jamiebrind/esp32-roller-blind/THIRD_PARTY_NOTICES.md

# Third-party notices

Dependencies are not vendored as library source in this repository. Prebuilt firmware contains code from the installed toolchain and libraries:

- Arduino-ESP32 3.3.12: https://github.com/espressif/arduino-esp32 — LGPL-2.1; see its licence files and component notices.
- ESP-IDF and its components: https://github.com/espressif/esp-idf — Apache-2.0 for ESP-IDF, with additional component licences/notices.
- ArduinoJson 7.4.3: https://github.com/bblanchon/ArduinoJson — MIT.

The Creative Commons licence on this adaptation does not replace these dependency licences. Corresponding application source, build versions and build instructions are provided under firmware/ and docs/FIRMWARE.md. Retrieve dependency source and notices from the linked upstream releases when rebuilding or redistributing binaries.
