jamiebrind/esp32-roller-blind/cad/RollerBlind_V15.step

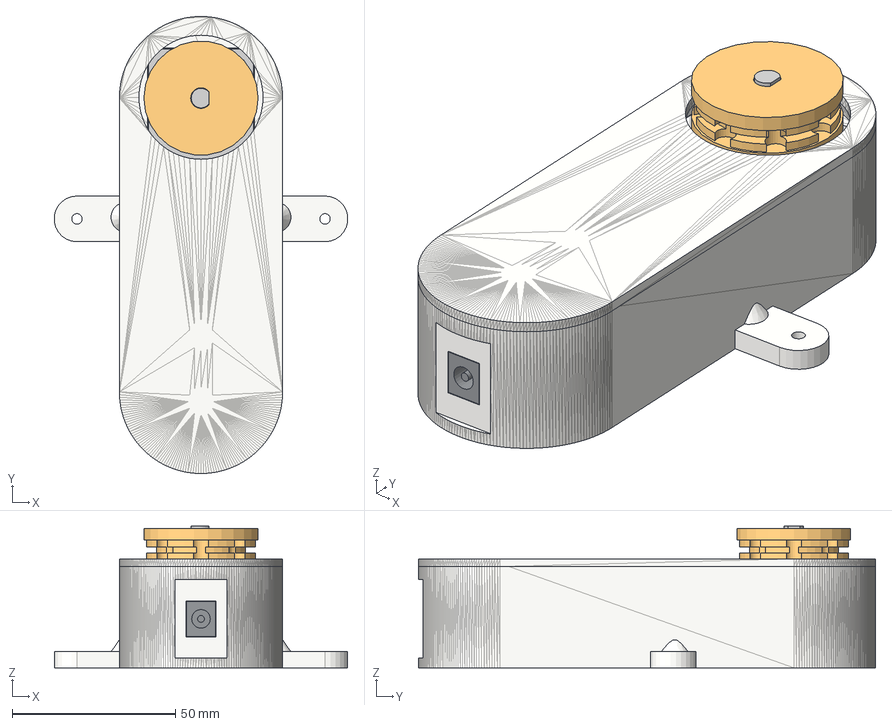
[picture p8: CAD file, 2026-10-14]
cad/RollerBlind_V15.step
89.9 x 140.0 x 43.4 mm
01_Original_housing
02_Original_cover
03_Tested_original_0p5_working_wheel
04_Original_electronics_insert
14_JGY370_12V20_MEASURED_BODY_NOMINAL_BOSSES
15_MEASURED_6mm_D_SHAFT_14mm_EXPOSED
17_MEASURED_DC_JACK_ENVELOPE_REFERENCE
