jamiebrind/esp32-roller-blind/cad/stl/01_Original_housing_V15.stl

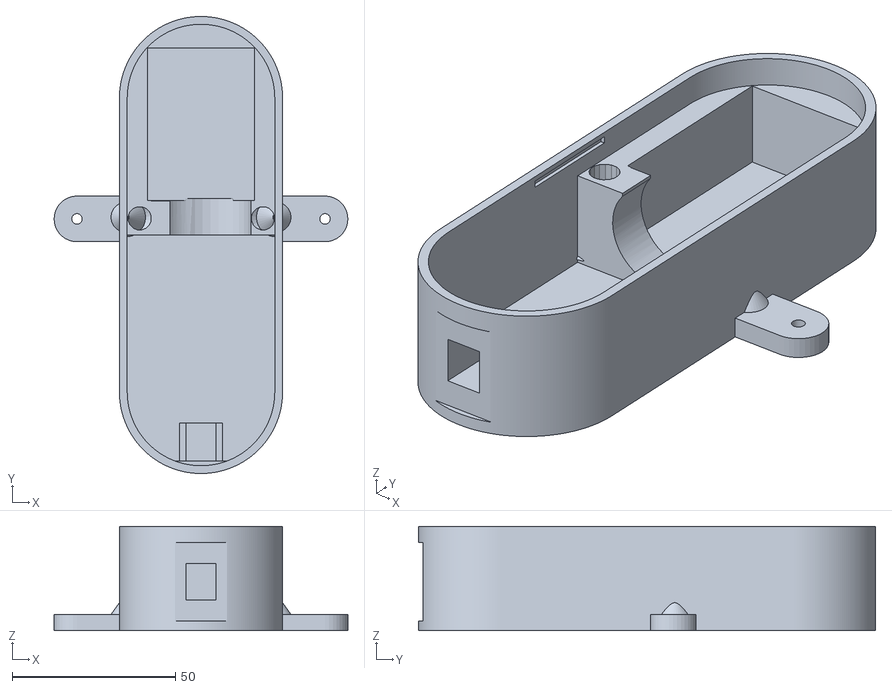
[picture p9: CAD file, 2026-10-14]
cad/stl/01_Original_housing_V15.stl
90.0 x 140.0 x 32.0
