jamiebrind/esp32-roller-blind/cad/stl/04_Original_electronics_insert_V15.stl

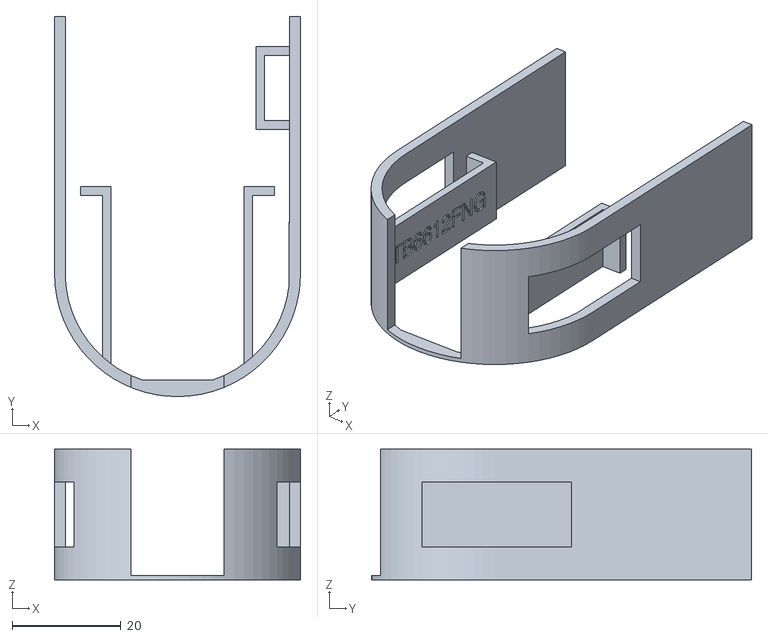
[picture p10: CAD file, 2026-10-14]
cad/stl/04_Original_electronics_insert_V15.stl
45.2 x 69.8 x 24.0
