jamiebrind/esp32-roller-blind/cad/stl/03_Tested_original_0p5_working_wheel_V15.stl

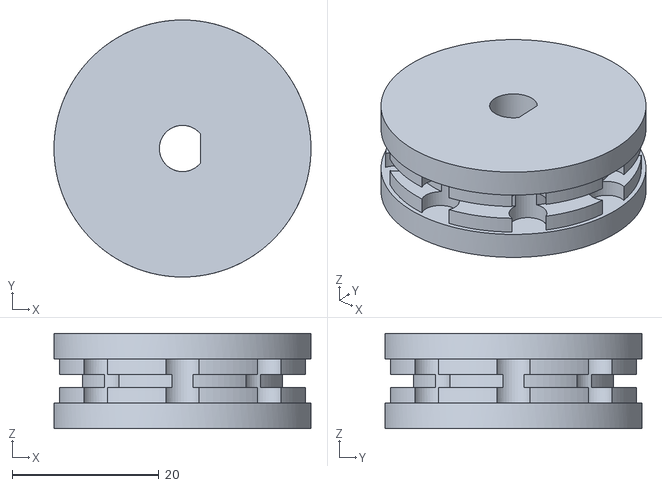
[picture p11: CAD file, 2026-10-14]
cad/stl/03_Tested_original_0p5_working_wheel_V15.stl
35.0 x 35.0 x 13.0
