jamiebrind/esp32-roller-blind/cad/stl/02_Original_cover_V15.stl

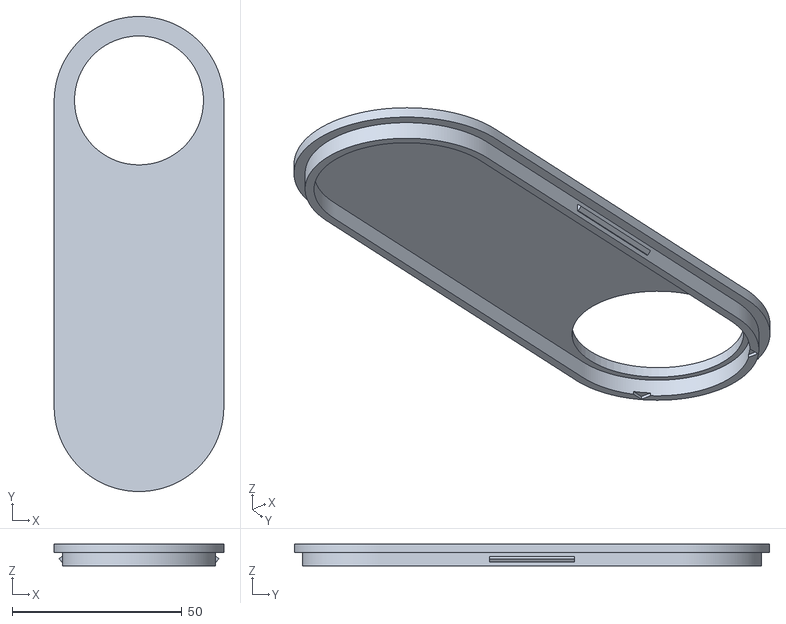
[picture p12: CAD file, 2026-10-14]
cad/stl/02_Original_cover_V15.stl
50.0 x 140.0 x 6.40
