jamiebrind/esp32-roller-blind/(list of files, cad)

Other CAD files:
cad/RollerBlind_V15.f3d
