jamiebrind/esp32-roller-blind/docs/Blind_Wiring_Drawings.pdf

# DETAILED WIRING - 12V / 3.3V POWER DISTRIBUTION

RB-EL-001 / REV B / 14 OCT 2026 / Firmware 2.0.2 / millimetres not applicable - schematic

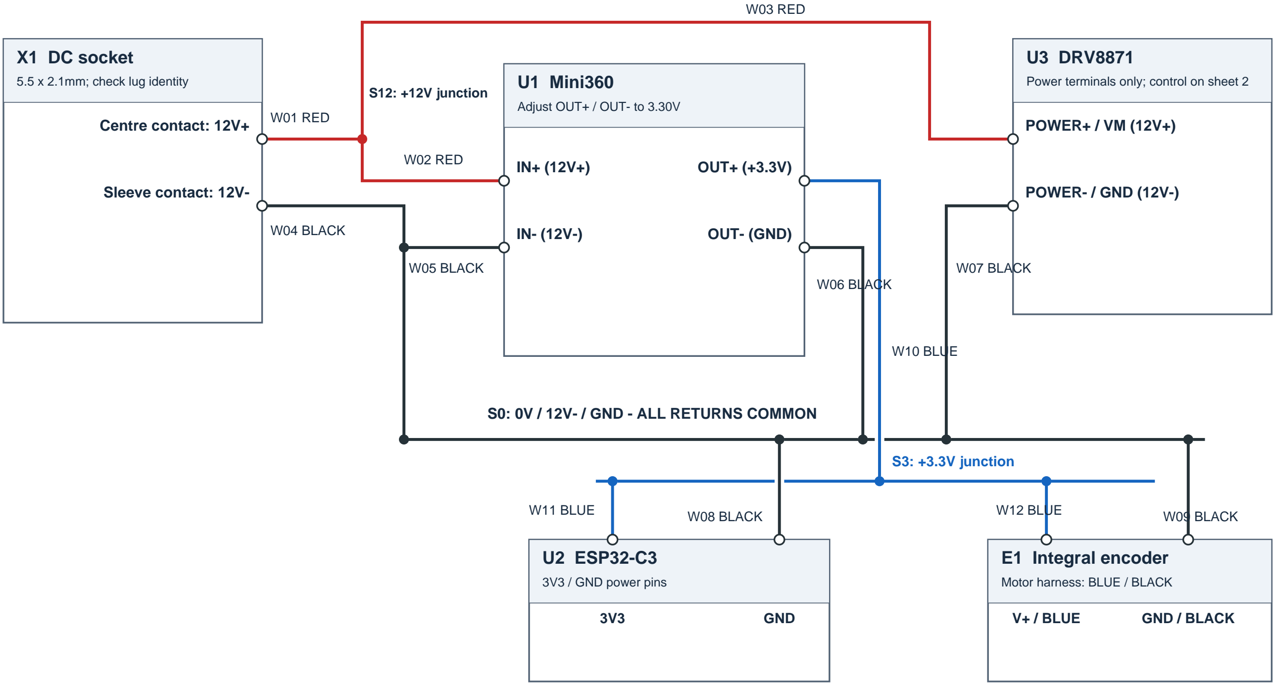
[picture p18: figure]
X1 DC socket; Adjust OUT+ / OUT- to 3.30V; U3 DRV8871; U2 ESP32-C3; 3V3 / GND power pins; E1 Integral encoder; Motor harness: BLUE / BLACK; Centre contact: 12V+; Sleeve contact: 12V-; OUT+ (+3.3V); OUT- (GND); POWER+ / VM (12V+); POWER- / GND (12V-); GND; V+ / BLUE; GND / BLACK; W01 RED; W02 RED; W03 RED; W04 BLACK; W05 BLACK; W06 BLACK; W07 BLACK; W08 BLACK; W09 BLACK; W10 BLUE; W11 BLUE; W12 BLUE; S12: +12V junction; S3: +3.3V junction

ESP32-C3 + DRV8871 + JGY-370 encoder motor | Terminal labels take precedence over board position.
RUN: 12V supply only. SERVICE USB: 12V OFF. Never feed ESP 3V3 from Mini360 while USB is connected.

1 / 3

5.5 x 2.1mm; check lug identity | U1 Mini360
Power terminals only; control on sheet 2

S0: 0V / 12V- / GND - ALL RETURNS COMMON

Solid dots = connected junctions. Crossing lines without a dot are NOT connected.
S12 / S0 / S3 are drawing labels for electrical joins, not extra terminal blocks in the BOM.
RED / BLACK / BLUE hookup-wire colours are suggested; E1 BLUE and BLACK are the confirmed harness colours. X1 switched third contact is unused; identify centre/sleeve with a meter, not by lug position.

# DETAILED WIRING - MOTOR DRIVE / ENCODER FEEDBACK

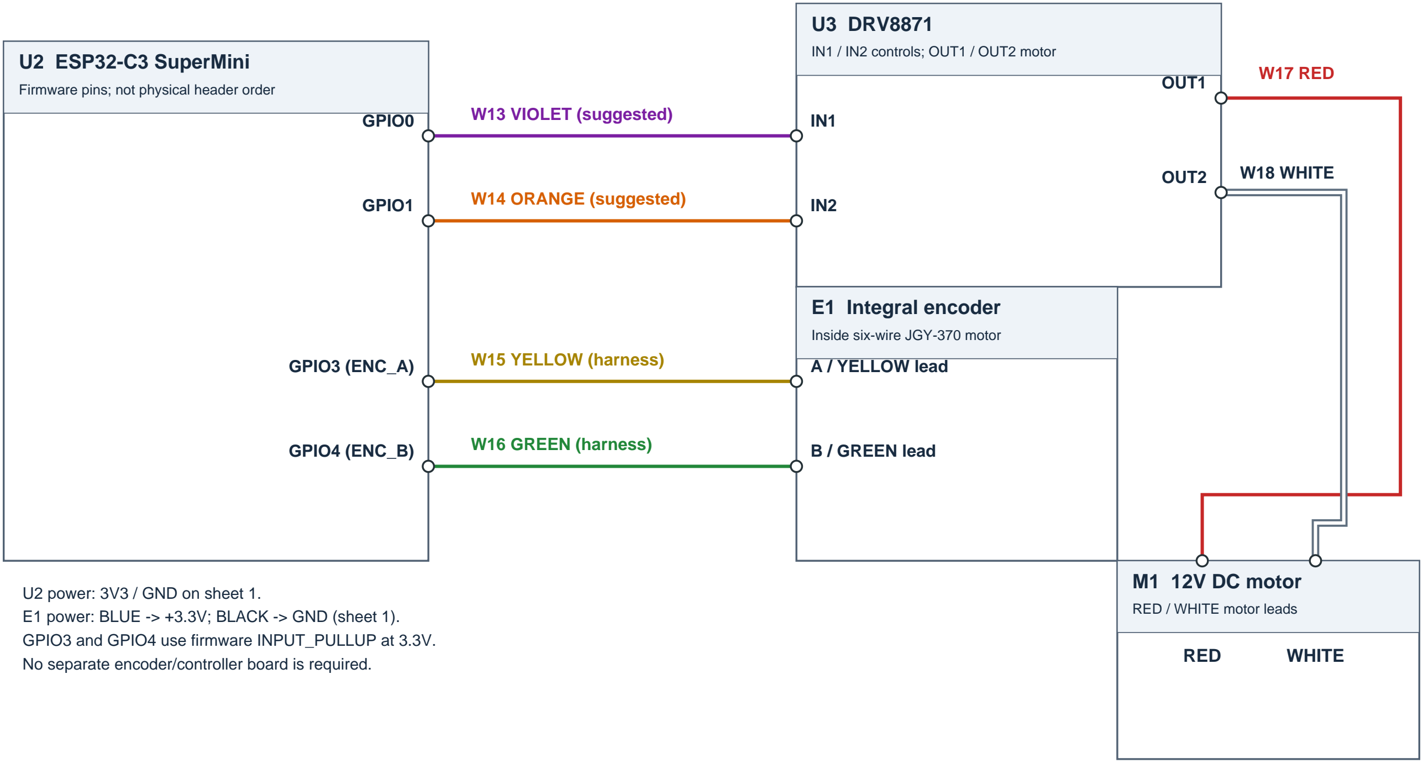
[picture p19: figure]
U2 ESP32-C3 SuperMini; U3 DRV8871; IN1 / IN2 controls; OUT1 / OUT2 motor; M1 12V DC motor; RED / WHITE motor leads; GPIO0; GPIO1; GPIO3 (ENC_A); GPIO4 (ENC_B); OUT1 OUT2; A / YELLOW lead; B / GREEN lead; RED; WHITE; W13 VIOLET (suggested); W14 ORANGE (suggested); W15 YELLOW (harness); W16 GREEN (harness); W17 RED; W18 WHITE; U2 power: 3V3 / GND on sheet 1.

2 / 3

Firmware pins; not physical header order

### E1 Integral encoder Inside six-wire JGY-370 motor

E1 power: BLUE -> +3.3V; BLACK -> GND (sheet 1). GPIO3 and GPIO4 use firmware INPUT_PULLUP at 3.3V. No separate encoder/controller board is required.

OUT1 / OUT2 reverse polarity with direction: WHITE is NOT a permanent 12V- / GND lead. Encoder BLACK = common 0V. Never apply +12V to the encoder supply or signal leads.

# HIGH-LEVEL OVERVIEW - LABELLED TERMINALS AND COLOURS

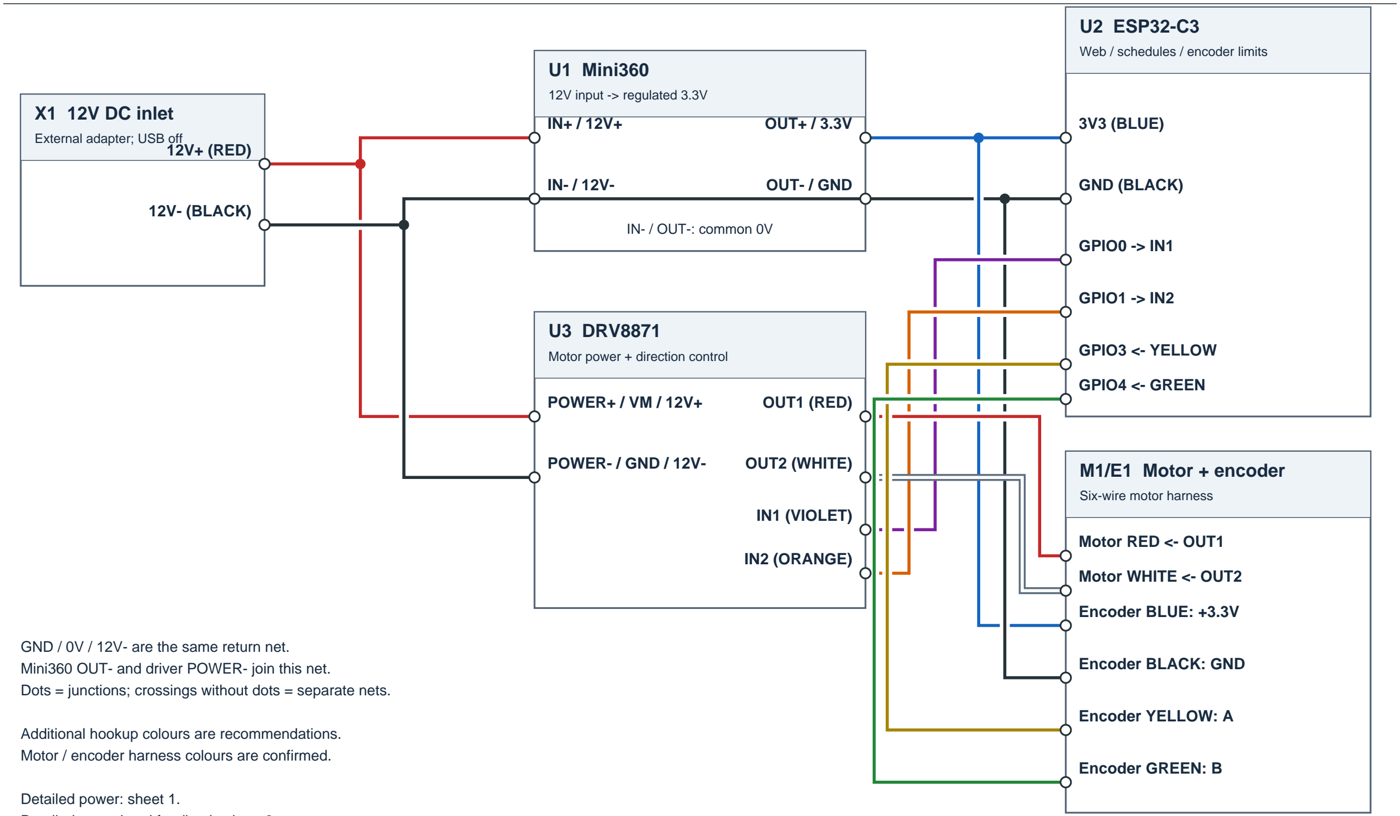
[picture p20: figure]
X1 12V DC inlet; External adapter; USB off; U1 Mini360; 12V input -> regulated 3.3V; U3 DRV8871; Motor power + direction control; U2 ESP32-C3; Web / schedules / encoder limits; M1/E1 Motor + encoder; Six-wire motor harness; IN- / OUT-: common 0V; 12V+ (RED); 12V- (BLACK); OUT+ / 3.3V; OUT- / GND; POWER+ / VM / 12V+; POWER- / GND / 12V-; OUT1 (RED); OUT2 (WHITE); IN1 (VIOLET); IN2 (ORANGE); 3V3 (BLUE); GND (BLACK); GPIO0 -> IN1; GPIO1 -> IN2; GPIO3 <- YELLOW; GPIO4 <- GREEN; Motor RED <- OUT1; Motor WHITE <- OUT2; Encoder BLUE: +3.3V; Encoder BLACK: GND; Encoder YELLOW: A; Encoder GREEN: B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

3 / 3

GND / 0V / 12V- are the same return net.
Mini360 OUT- and driver POWER- join this net.
Dots = junctions; crossings without dots = separate nets.

Motor / encoder harness colours are confirmed.

Detailed control and feedback: sheet 2.
