jamiebrind/esp32-roller-blind/CHANGELOG.md

# Changelog

## 2.0.4 — 14 October 2026

- Automatically restore a valid last stopped position after restart, assuming the chain did not move while off.
- Retain recovery requirements for interrupted movement, invalid/missing saved position and mismatched calibration.
- Keep the motor stopped on boot and retain missed-event suppression.
- Raw encoder count resets at boot; the saved logical position uses an offset.
- Verified: 21 C++ suites, 10 JavaScript cases, 4 Python cases and independent review. Real Wi-Fi update/restart retained the prototype’s known stopped position, schedules and calibration without recovery. A physical cold power-cycle test remains separate from this firmware-restart check.

## 2.0.3 — 14 October 2026

- Fix edited schedules being suppressed for the rest of the day after the same rule ID was executed or skipped.
- Record claims against the schedule definition, including relevant solar location and offset.
- Persist migration of 2.0.2 history before schedule edits are accepted; upgrading does not replay old events.
- Keep live settings identical to their stored JSON representation, making solar claim identities stable over restart.
- Unchanged rules retain duplicate-run protection; past times are never replayed on save.
- No motor wiring, calibration method, 60-second cap or reboot position-confirmation change.

Verified: 20 C++ suites, 10 JavaScript cases and 4 Python cases; independent review passed. Real Wi-Fi installation, reboot and retained settings/calibration/password were verified. No motor movement was commanded during installation. After the builder recalibrated, a real timed 20% raise and a same-rule edit to a timed 0% lower both ran with encoder feedback, stopped at their reported targets and produced no faults. The original schedule settings were restored afterward.
