jamiebrind/esp32-roller-blind/firmware/tests/test_release.py

from pathlib import Path
import hashlib,json,subprocess,sys,tempfile,unittest
ROOT=Path(__file__).resolve().parents[1]
class Release(unittest.TestCase):
 def test_manifest_and_wrong_image(self):
  test_root=ROOT/'tests'/'temp';test_root.mkdir(exist_ok=True)
  with tempfile.TemporaryDirectory(dir=test_root) as temp:
   directory=Path(temp);assert directory.resolve().is_relative_to(test_root.resolve());binary=directory/'app.bin';manifest=directory/'manifest.json';image=bytearray(300);image[0]=0xe9;image[12]=5;image[32:36]=bytes.fromhex('3254cdab');binary.write_bytes(image)
   command=[sys.executable,str(ROOT/'tools/release_manifest.py'),'--binary',str(binary),'--version','2.0.0','--output',str(manifest)]
   self.assertEqual(subprocess.run(command,capture_output=True).returncode,0)
   data=json.loads(manifest.read_text());self.assertEqual(data['length'],300);self.assertEqual(data['sha256'],hashlib.sha256(image).hexdigest())
   image[12]=0;binary.write_bytes(image);self.assertNotEqual(subprocess.run(command,capture_output=True).returncode,0)
if __name__=='__main__':unittest.main()
