jamiebrind/esp32-roller-blind/(commit log)

2026-10-14 Publish V15 CAD, controller 2.0.2 and illustrated build guide
    [01_Original_housing_V15.stl, 02_Original_cover_V15.stl, 03_Tested_original_0p5_working_wheel_V15.stl, 04_Original_electronics_insert_V15.stl, BOM.csv, RollerBlind_V15.f3d, RollerBlind_V15.step, partitions.csv]
2026-10-14 Document actual superglue mounting and M3 wheel retention
    [BOM.csv]
2026-10-14 Add six-view Fusion CAD gallery and illustrated assembly steps
2026-10-14 Add detailed terminal wiring sheets, colour wire list and system overview
    [WIRE_LIST.csv]
2026-10-14 Fix edited schedules and persist versioned occurrence history
    [partitions.csv]
