jamiebrind/esp32-roller-blind/docs/images/installed-side.jpg

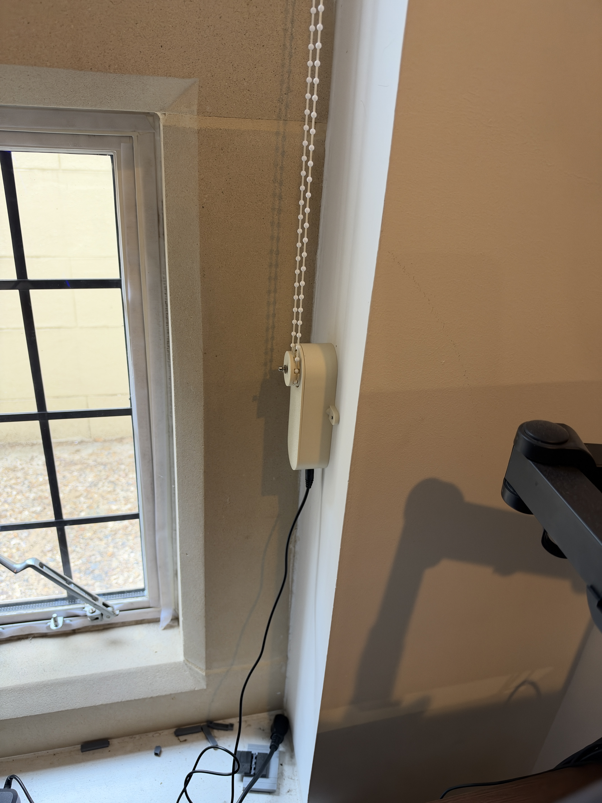
[picture p16: docs/images/installed-side.jpg]
docs/images/installed-side.jpg
