jamiebrind/esp32-roller-blind/docs/images/installed-overview.jpg

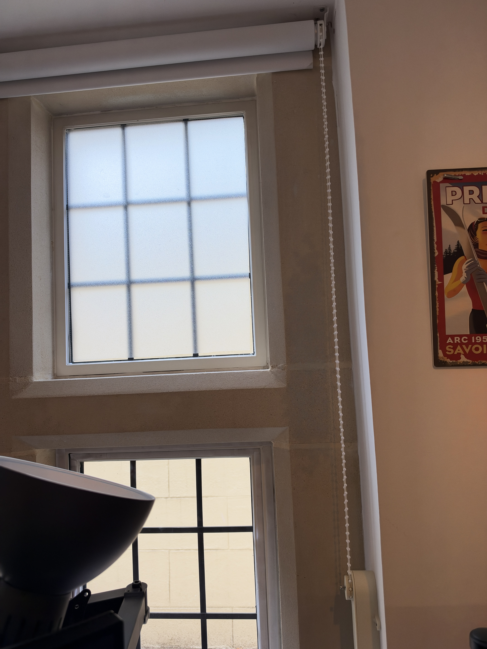
[picture p17: docs/images/installed-overview.jpg]
docs/images/installed-overview.jpg
